NerevarMoonAndStar/Attempting-Slam-Through-Minimalist-IMU-and-Ultrasonic-Sensing/ScanResults.png

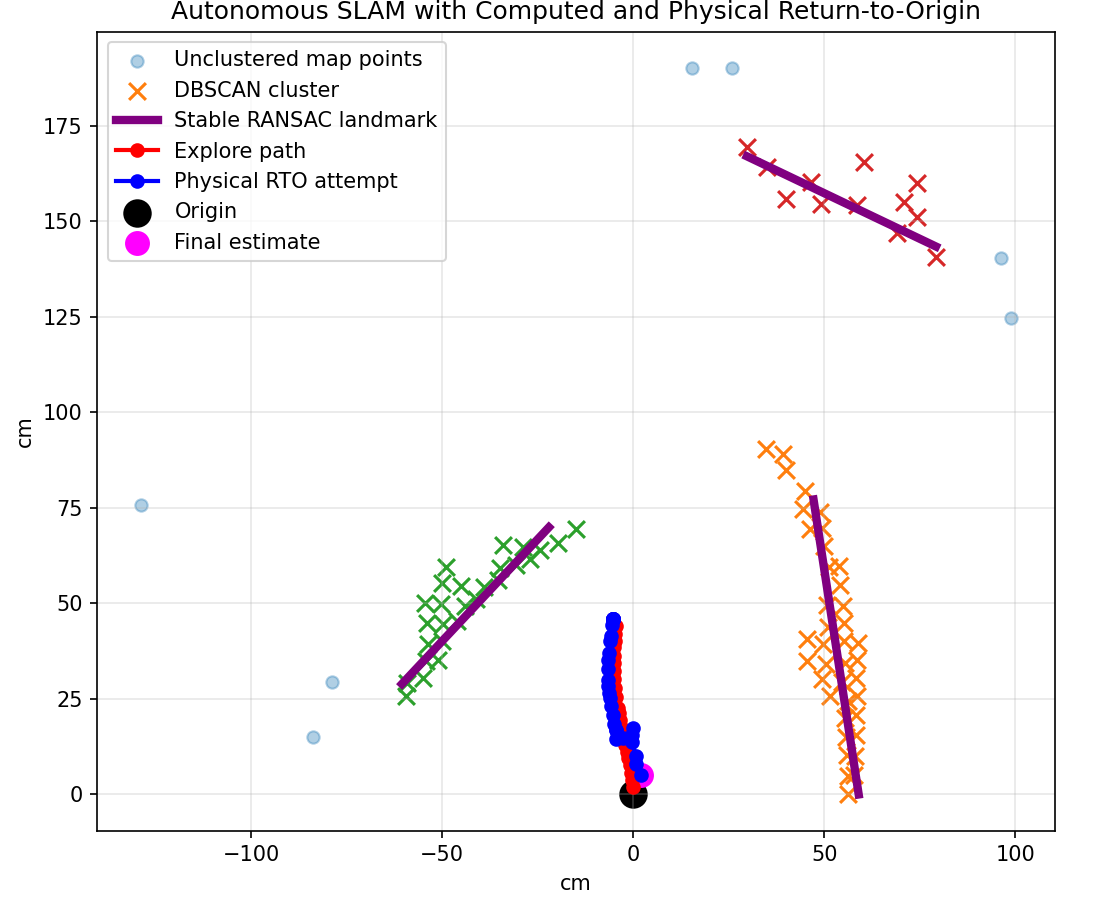
ScanResults.png
